VictorRavani/Belliz_IOT/Hardware/Placa V2 Fabricação/Rederização placa traseira.png

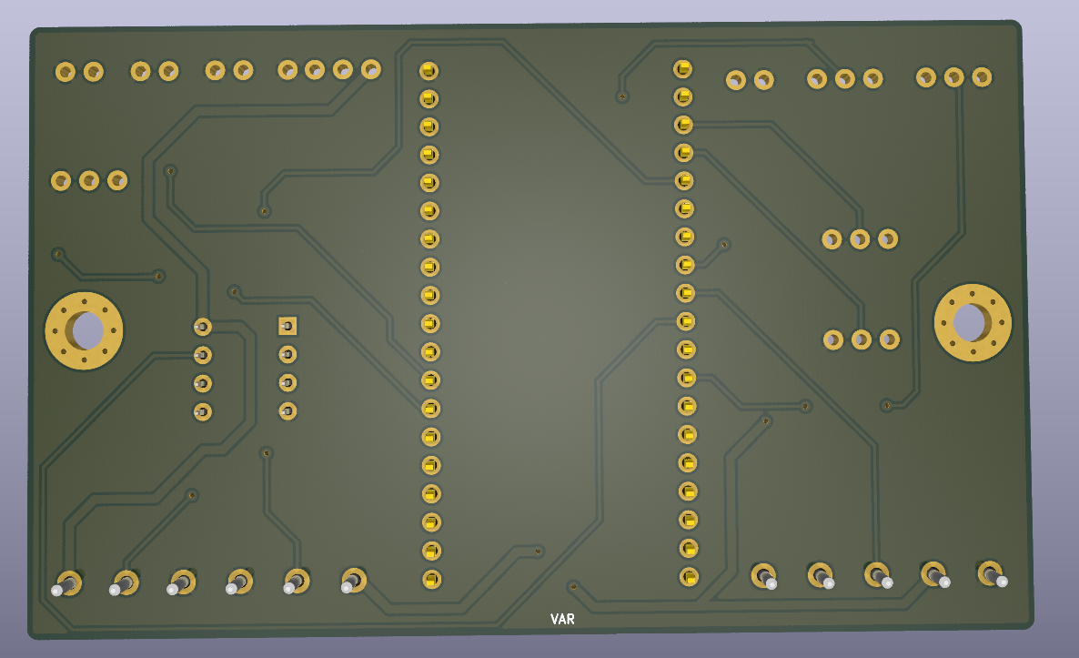
Hardware/Placa V2 Fabricação/Rederização placa traseira.png
