VictorRavani/Belliz_IOT/Documentos/Pinout ESP32 38pins.png

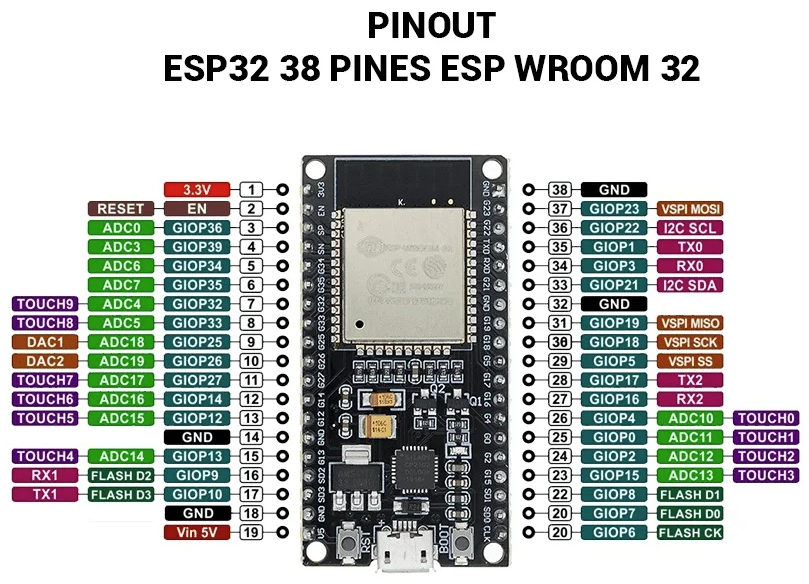
Documentos/Pinout ESP32 38pins.png
