VictorRavani/Belliz_IOT/Hardware/Identificação dos Cabos.xlsx

Nome | Quantidade
RELE 1 NA | 2
RELE 1 NA | 2
RELE 2 NA | 2
RELE 2 NA | 2
12V BZ | 2
GND BZ | 2
OUT FIRE | 2
12V DETECTOR | 2
GND DETECTOR | 2
