VictorRavani/Belliz_IOT/Documentos/Atualização OTA.docx

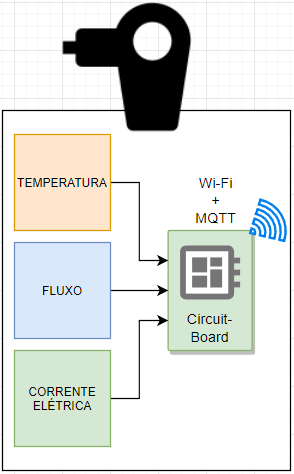
[picture p20: figure]

- Atualização OTA (Over-the-Air)
- Liga metade da planta por 15min e desliga 15min.
- NTP Server para atualização da hora.
- Enviar Json a cada 1 min
- Formato do Json:

{

"temp":158,

"flow":85,

"electric_current":8

}

- 16 Placas independentes para envio das informações p/

a plataforma da Azure.

- A placa 01 será um pouco diferente pois ela irá controlar

os ciclos de 15 min (conector KRE DNP)
