VictorRavani/Belliz_IOT/Documentos/Bancada de secadores.png

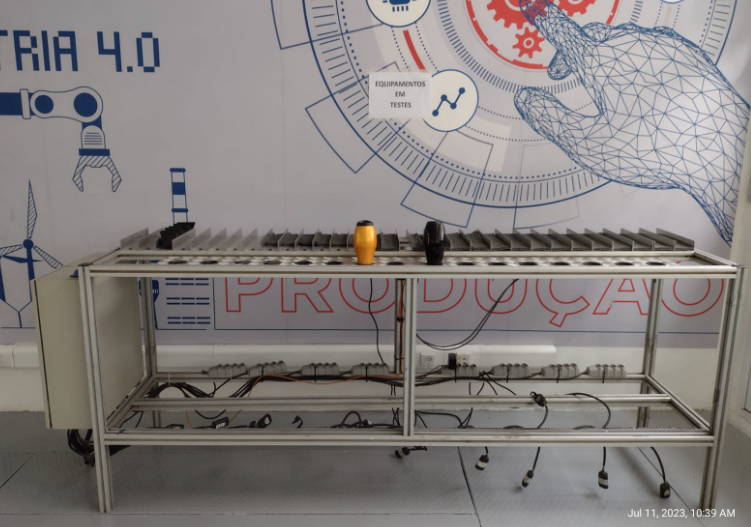
Documentos/Bancada de secadores.png
