VictorRavani/Belliz_IOT/Documentos/Captura de tela 2024-01-05 143502.png

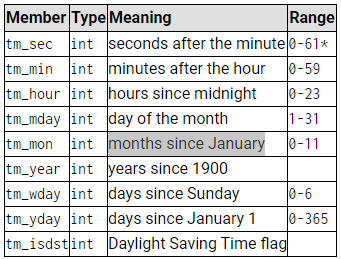
Documentos/Captura de tela 2024-01-05 143502.png
