VictorRavani/Belliz_IOT/Documentos/Esquema ligação ideia 1.png

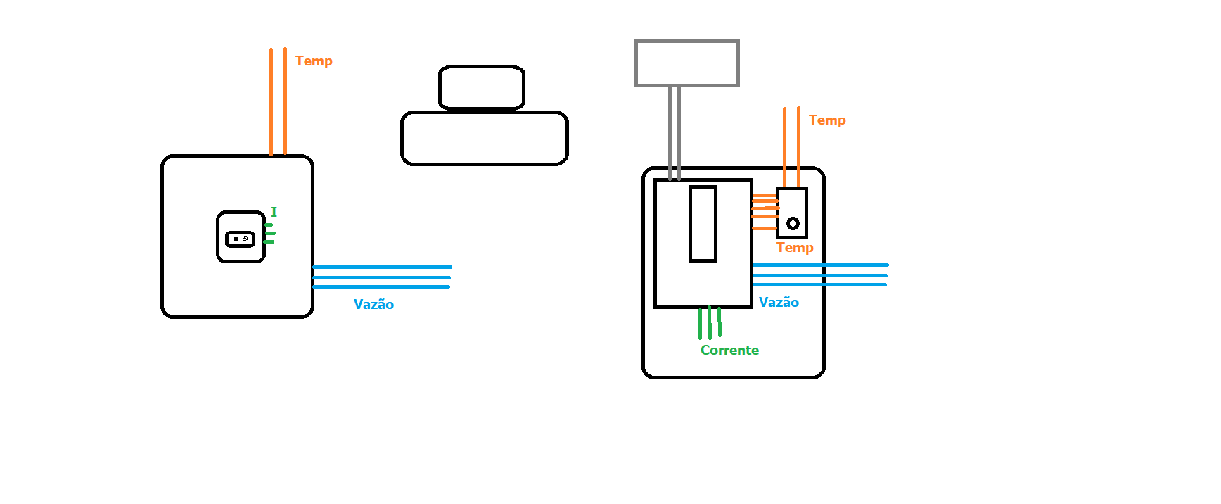
Documentos/Esquema ligação ideia 1.png
