VictorRavani/Belliz_IOT/Documentos/FireBaseConfig.png

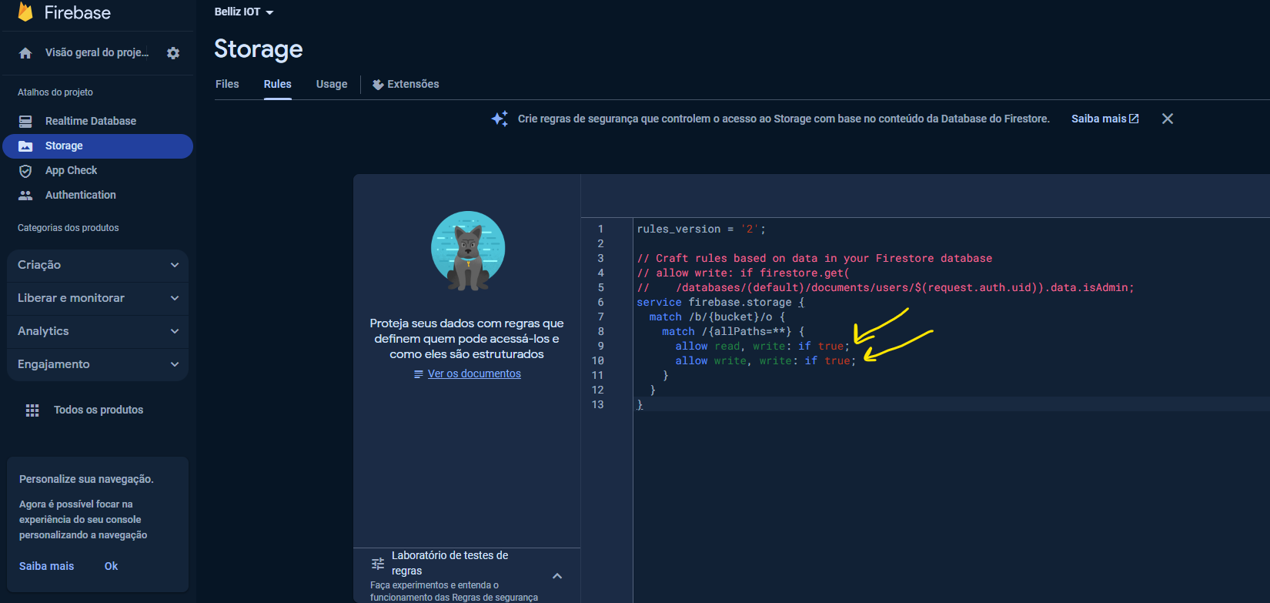
Documentos/FireBaseConfig.png
