VictorRavani/Belliz_IOT/Documentos/Placa 3D.png

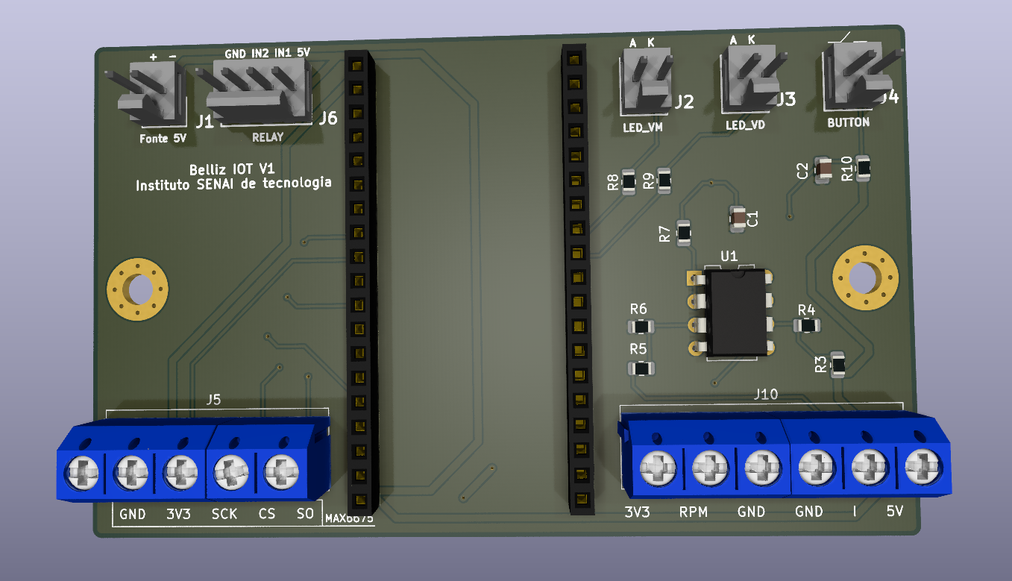
Documentos/Placa 3D.png
