VictorRavani/Belliz_IOT/Documentos/RPM.png

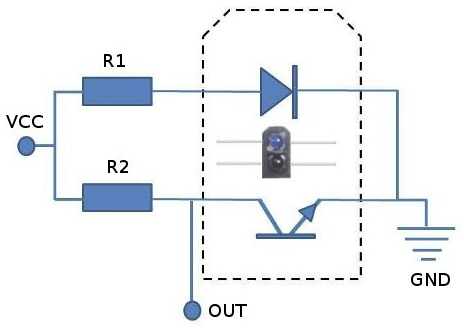
Documentos/RPM.png
