VictorRavani/Belliz_IOT/Gustavo/TAGO_IO.jpg

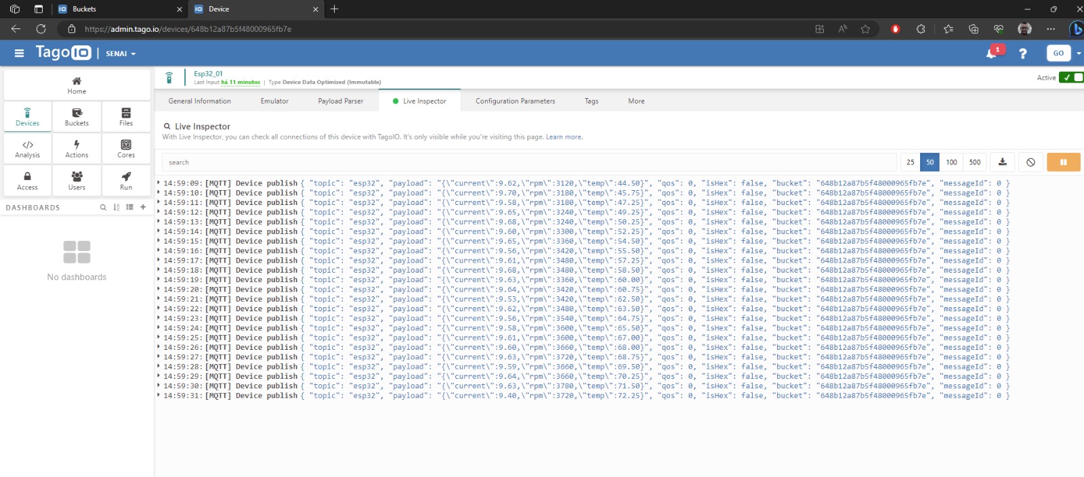
Gustavo/TAGO_IO.jpg
