VictorRavani/Belliz_IOT/Hardware/Circuito Elétrico/Circuito Relé.png

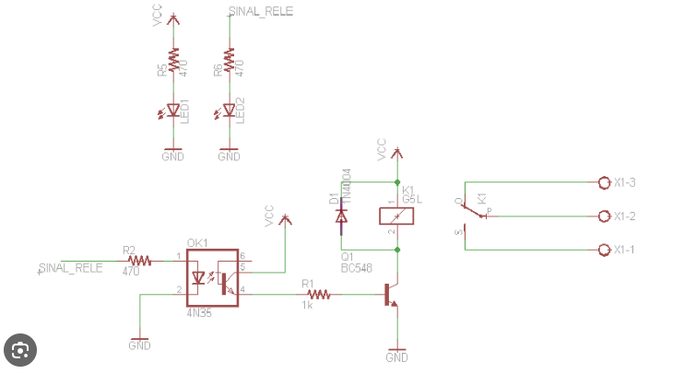
Hardware/Circuito Elétrico/Circuito Relé.png
