VictorRavani/Belliz_IOT/Hardware/Circuito Elétrico/Pin_Out_ESP32-38pins.png

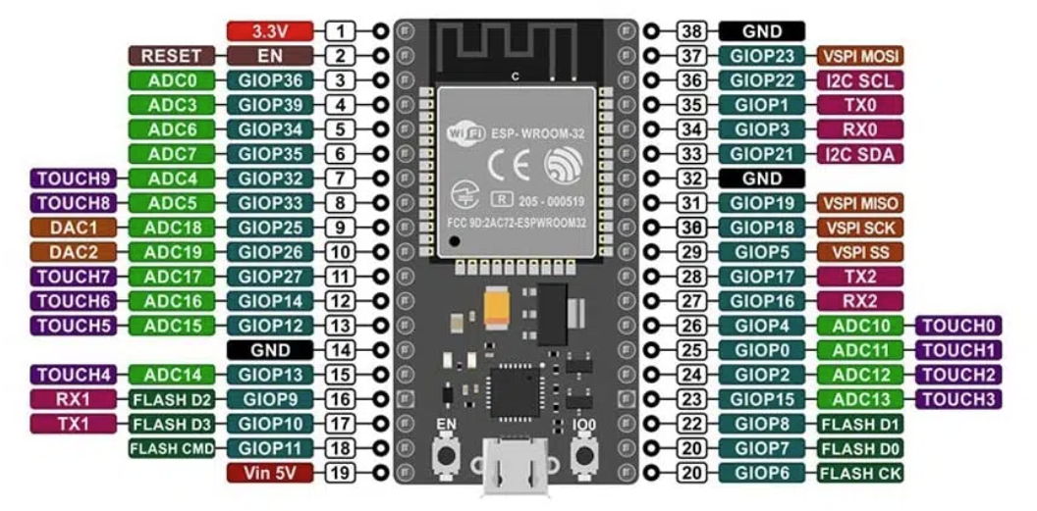
Hardware/Circuito Elétrico/Pin_Out_ESP32-38pins.png
