VictorRavani/Belliz_IOT/Hardware/PCB_Belliz_IOT.png

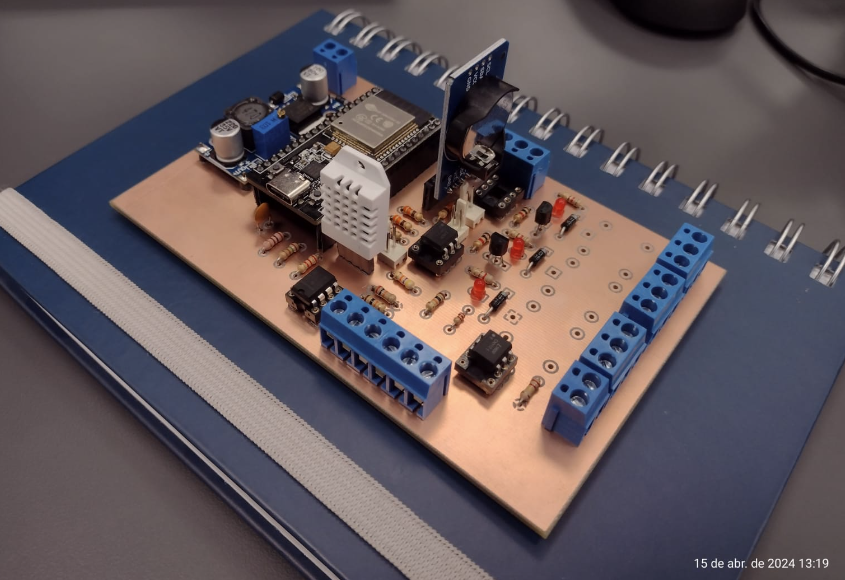
Hardware/PCB_Belliz_IOT.png
