VictorRavani/Belliz_IOT/Hardware/Circuito Elétrico/BoM - Bill of Materials - BELLIZ_IOT - (PCB v1.1).xlsx

Bill of Materials
Company Name: |  |  | Instituto SENAI de tecnologia em eletrônica e automação
 |  | Address | R. Jaguaré Mirim, 71 - Vila Leopoldina, São Paulo - SP, 05311-020 - Setor: IST - Eletrônica
 |  | Authorized persons | Victor Ravani; Gustavo Oliveira; Igor Messias; Fabio Rizzo
Project Name: |  |  | Belliz IOT – (PCB 1.1)
RESISTORS
ID | Qty. | Part Designator | Manufacturer Number | Description
1 | 1 | R1 | Resistor SMD 4K7 0805 0,125W (1/8W) 5% (https://www.mamuteeletronica.com.br/resistor-smd-4k7-0805-0125w-1-8w-5-713) | Resistor SMD 0805 4K7
2 | 8 | R2, R11, R12, R13, R14, R15, R16, R17 (All DNP) | Resistor SMD 0R 0805 | Resistor SMD 0805 0R
3 | 1 | R3 | Resistor SMD 750R 0805 | Resistor SMD 0805 750R
4 | 1 | R4 | Resistor SMD 2K2 0805 0,125W (1/8W) 5% (https://www.mamuteeletronica.com.br/resistor-smd-2k2-0805-0125w-1-8w-5-1029) | Resistor SMD 0805 2K2
5 | 2 | R5, R10 | Resistor SMD 10K 0805 0,125W (1/8W) 5% (https://www.mamuteeletronica.com.br/resistor-smd-10k-0805-0125w-1-8w-5-1028) | Resistor SMD 0805 10K
6 | 1 | R6 | Resistor SMD 20K 0805 | Resistor SMD 0805 20K
7 | 1 | R7 | Resistor SMD 100R 0805 | Resistor SMD 0805 100R
8 | 2 | R8, R9 | Resistor SMD 330R 0805 0,125W (1/8W) 5% (https://www.mamuteeletronica.com.br/resistor-smd-330r-0805-0125w-1-8w-5-1506) | Resistor SMD 0805 330R
CAPACITORS
ID | Qty. | Part Designator | Manufacturer Number | Description
1 | 2 | C1, C2 | Capacitor Cerâmico Smd 100nf 0805 50v X7r (https://www.mamuteeletronica.com.br/capacitor-ceramico-smd-100nf-0805-50v-x7r-k-10-4640) | Capacitor cerâmico SMD 0805 100nF
INTREGRATED CIRCUITS
ID | Qty. | Part Designator | Manufacturer Number | Description
1 | 1 | U1 | LM358 | Integrated Circuit
SYSTEM ON MODULE
ID | Qty. | Part Designator | Manufacturer Number | Description
1 | 1 | IC1 | ESP32 | Microcontroller
CONNECTORS
ID | Qty. | Part Designator | Manufacturer Number | Description
1 | 4 | J1, J2, J3, J4 | Conector KK 2 vias | Conector
2 | 1 | J6 | Conector KK 4 vias | Conector
3 | 5 | J7(DNP), J11, J12(DNP), J13(DNP), J14(DNP) | Conector KK 3 vias | Conector
4 | 1 | J10, | Conector KRE 6 vias | Conector
5 | 1 | J15 | Conector KRE 5 vias | Conector
6 | 2 | J8, J9 | Pin header female 19 vias | Conector
