VictorRavani/Belliz_IOT/Hardware/Placa V2 Fabricação/Lista de componentes.xlsx

#Or. | Components | Designator | Unitário | Quantidade | Final |  |  | Valor
1 | Alojamento metálico KK (fêmea) |  | 12 | 216 |  |  |  |  | 0
2 | Amplificador Operacional LM358 DIP |  | 1 | 18 |  |  | https://www.acheicomponentes.com.br/ci-lm358p-dip8-texas | 2 | 2
3 | Capacitor de cerâmica SMD 0805 100nF |  | 2 | 36 |  |  | https://www.acheicomponentes.com.br/capacitores/100-pecas-capacitor-ceramico-multicamadas-100nf-50v-smd-0805-10 | 15 | 15
4 | Conector KK 2 vias fêmea 180° |  | 4 | 72
5 | Conector KK 2 vias macho 180° |  | 4 | 72 |  | https://www.saravati.com.br/conector-kk-macho-2-54mm-02-vias-180o.html | https://www.acheicomponentes.com.br/conector/conector-kk-2-vias-macho-180-2-54mm-5045-02-ds1070-02mvv6 | 0.3 | 1.2
6 | Conector KK 3 vias fêmea 180° |  | 5 | 90
7 | Conector KK 3 vias macho 180° |  | 5 | 90 |  |  | https://www.acheicomponentes.com.br/conector/conector-kk-3-vias-macho-180-2-54mm-5045-03-ds1070-03mvv6 | 0.35 | 1.75
8 | Conector KK 4 vias fêmea 180° |  | 1 | 18
9 | Conector KK 4 vias macho 180° |  | 1 | 18 |  |  | https://www.acheicomponentes.com.br/conector/conector-kk-4-vias-macho-180-2-54mm-5045-04-ds1070-04mvv6 | 0.5 | 0.5
10 | Conector mini KRE 2 vias |  | 1 | 18 |  | https://www.saravati.com.br/borne-azul-kre2-kf-301-2-terminais-180-mini.html | https://www.acheicomponentes.com.br/borne-kre-2-vias-kf-301-2t-azul-mini | 1.55 | 1.55
11 | Conector mini KRE 3 vias |  | 3 | 54 |  | https://www.saravati.com.br/borne-azul-kre2-kf-301-3-terminais-180-mini.html | https://www.acheicomponentes.com.br/borne-kre-3-vias-kf-301-3t-azul-mini | 1.5 | 4.5
12 | Conector P4 rosca |  | 1 | 16 |  |  |  |  |  | 1504
13 | Resistor SMD 0805 0R |  | 4 | 72 |  |  | https://www.acheicomponentes.com.br/resistor/resistor-em-smd/0805/kit-100-pecas-resistor-0r-smd-0805-5 | 6 | 6
14 | Resistor SMD 0805 100R |  | 1 | 18 |  |  | https://www.acheicomponentes.com.br/resistor/resistor-em-smd/0805/100-pecas-resistor-100r-smd-0805-1 | 8 | 8
15 | Resistor SMD 0805 10K |  | 2 | 36 |  |  | https://www.acheicomponentes.com.br/resistor/resistor-em-smd/0805/100-pecas-resistor-10k-0805-smd-1 | 8 | 8
16 | Resistor SMD 0805 20K |  | 1 | 18 |  |  | https://www.acheicomponentes.com.br/resistor/resistor-em-smd/0805/100-pecas-resistor-20k-smd-0805-1 | 8 | 8
17 | Resistor SMD 0805 2K2 |  | 1 | 18 |  |  | https://www.acheicomponentes.com.br/resistor/resistor-em-smd/0805/100-pecas-resistor-2k2-smd-0805-1 | 8 | 8
18 | Resistor SMD 0805 330R |  | 2 | 36 |  |  | https://www.acheicomponentes.com.br/circuitos-integrados/dip-pth/100-pecas-resistor-330r-0-1w-smd-0805-5 | 8 | 8
19 | Resistor SMD 0805 4K7 |  | 1 | 18 |  |  | https://www.acheicomponentes.com.br/resistor/resistor-em-smd/0805/100-pecas-resistor-4k7-smd-0805-1 | 8 | 8
20 | Resistor SMD 0805 750R |  | 1 | 18 |  |  |  | 8 | 8
21 | Soquete Barra de Pinos 1x20 180 Graus Passo 2,54mm Fêmea | J8, J9 | 2 | 36 |  | https://www.saravati.com.br/soquete-barra-de-pinos-1x20-mci-180-graus-passo-2-54mm.html | https://www.acheicomponentes.com.br/barra-de-pinos/femea/20-vias-pinos/barra-de-pinos-femea-dupla-mci-1x20-180o-passo-2-54mm-ds1023-1-20s21 | 1.6 | 3.2
22 | Soquete Torneado 8 Pinos DIP |  | 1 | 18 |  |  | https://www.acheicomponentes.com.br/soquete/torneado/soquete-torneado-dip-pth-8-pinos-ou-pernas | 2.4 | 2.4
 | Kit 5 peças - Rele 5V 15A 5 pinos - Metaltex (AX1RC) |  |  | 3
