VictorRavani/Belliz_IOT/Documentos/Compras 3 Belliz_IOT.xlsx

Descrição | Qty | Valor Uni. | Total
Sensor de Temperatura e Umidade Digital DHT22 (https://www.saravati.com.br/sensor-de-temperatura-e-umidade-digital-dht22.html) | 2 | R$39.90 | R$79.80
Adaptador Plugue P4 Macho x Borne (https://www.saravati.com.br/adaptador-plugue-p4-macho-x-borne.html) | 5 | R$3.00 | R$15.00
Fonte Bivolt 100-240V 12V 1A Plug P4 (https://www.saravati.com.br/fonte-bivolt-100-240v-12v-1a-plug-p4.html) | 16 | R$17.90 | R$286.40
Módulo Regulador de Tensão LM2596 DC/DC Step Down (https://www.saravati.com.br/modulo-regulador-de-tensao-lm2596-dc-dc-step-down.html) | 16 | R$11.90 | R$190.40
Total |  |  | R$571.60
