VictorRavani/Belliz_IOT/Documentos/gráficos.xlsx

Sheet: Planilha1
Entregue | Conector Tomada 3 pinos 10A | 16 | R$14.00 | R$224.00 | PCB's | Usar ACS fusíveis, medir temperatura
Entregue | Plug Tomada 3 pinoa 10A | 16 | R$5.00 | R$80.00 | Componentes Eletrônicos
Entregue | Placa ESP32 WiFi / Bluetooth ESP32S CP2102 38 Pinos | 16 | R$64.43 | R$1030.88
 |  |  |  | R$0.00
Entregue | Sensor de Corrente ACS712 20A | 16 | R$15.21 | R$243.36
Entregue | Módulo de Temperatura MAX6675 + Sensor Termopar tipo K | 16 | R$49.41 | R$790.56
Entregue | TCRT5000 | 16 | R$1.99 | R$31.84
Entregue | Microventilador 110-220Vac 50/60Hz 80x80mm | 16 | R$54.60 | R$873.60
Entregue | Tubo de PVC 12 metros | 16 |  | R$0.00
 | Impressão 3D case temperatura | 16 |  | R$0.00
 | Cabo Manga blindado 5 vias |  |  | R$0.00
 | Fabricação e montagem das placas completa |  |  | R$0.00
 | Conversor ADS1115 |  |  | R$0.00
 | Parafusos caixa patola externo 4 uni |  |  | R$0.00
 | Parafusos Placa 2 uni |  |  | R$0.00
Entregue | Caixa patola Placa |  |  | R$0.00
Entregue | Fonte para ESP32 5V 2.2A Micro USB | 16 | 18.41 | R$294.56
 | Parafusos caixa patola e tomada sobrepor 4 unidades |  |  | R$0.00
 | Parafuso case 3D sensor de temperatura unidades |  |  | R$0.00
 | Parafuso e procas ventilador e tudo 4 uni pequeno 4 uni grande |  |  | R$0.00
 | Parafuso tubo e bancada 6 uni e 6 porcas |  |  | R$0.00
 |  |  |  | R$0.00
 |  |  |  | R$0.00
 |  |  |  |  |  | Temperatura de trabalho TCRT5000: -25 °C ~ +85 °C
 | https://www.usinainfo.com.br/sensor-de-fluxo-arduino/sensor-de-fluxo-de-agua-yf-s403-g34-1-60-lmin-3523.html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
 | https://www.baudaeletronica.com.br/sensor-de-fluxo-de-agua-3-4-yf-s403.html
 | https://www.saravati.com.br/sensor-de-corrente-nao-invasivo-sct-013-20a-1v.html

Sheet: Custo unitário
 |  |  |  |  | Custo Máximo: | R$1250.00
 | Placa ESP32 | 1 | R$58.41 | link (https://www.saravati.com.br/produto/placa-esp32-wifi-bluetooth-esp32-cp2102-30-pinos-usb-c.html) | Custo Atual: | R$805.29
ok | Conjunto Tomada de Sobrepor 2P+T 20A 250V Box Branco | 1 | R$7.50 | link (https://www.obramax.com.br/conjunto-tomada-de-sobrepor-2pt-20a-250v-box-branco-89151552.html?region_id=138913)
ok | PLUG DE SOBREPOR 2P+T 20A MACHO PRETO FAME | 1 | R$7.93 | link (https://www.eletrorastro.com.br/produto/plug-de-sobrepor-2p-t-20a-macho-preto-fame-81553)
 | Caixa Patola PB-115 para Montagem 50 x 112 x 160 mm | 1 | R$33.73 | link (https://www.usinainfo.com.br/caixas-patola/caixa-patola-pb-115-para-montagem-50-x-112-x-160-mm-8282.html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)
 | Tubo de PVC | 1 | R$50.00 |  |  |  | Processo de compras 1 - Eletrônica
 | PCB | 1 | R$100.00 |  |  |  | Descrição | Quantidade | Link referência
ok | Sensor de Temperatura MAX6675 com Termopar Tipo K | 1 | R$33.70 | link (https://www.wjcomponentes.com.br/sensores/max-6675-com-termopar-tipo-k?parceiro=6298) |  |  | Caixa Plástica PB-115 - Patola - Caixa 24 | 17 | link (https://www.multcomercial.com.br/caixa-plastica-pb-115-patola-caixa-24.html) | Eletrônica
ok | Sensor de Corrente ACS712 20A | 1 | R$15.21 | link (https://www.saravati.com.br/sensor-de-corrente-acs712-20a) |  |  | Fonte Bivolt 100-240V 5V 1A Plug P4 | 17 | link (https://www.saravati.com.br/fonte-bivolt-100-240v-5v-1a-plug-p4) | Eletrônica
 | Sensor de Vazão | 1 | R$294.50 | link (https://www.marinostore.com/sensores/sensor-de-fluxo-de-agua-2-polegada-fy-dn50) |  |  | Placa ESP32 WiFi / Bluetooth ESP32 CP2102 38 Pinos USB-C | 17 | link (https://www.saravati.com.br/produto/placa-esp32-wifi-bluetooth-esp32-cp2102-30-pinos-usb-c.html) | Eletrônica
 | Componentes da placa | 1 | R$150.00 |  |  |  | Sensor de Corrente ACS712 20A | 17 | link (https://www.saravati.com.br/sensor-de-corrente-acs712-20a) | Eletrônica
Delanese | Parafusos e peças mecânicas | 1 | R$40.00 |  |  |  | Sensor de Temperatura MAX6675 com Termopar Tipo K | 17 | link (https://www.saravati.com.br/modulo-sensor-de-temperatura-max6675-termopar-tipo-k) | Eletrônica
 | Fonte Bivolt 100-240V 5V 1A Plug P4 | 1 | R$14.31 | link (https://www.saravati.com.br/fonte-bivolt-100-240v-5v-1a-plug-p4) |  |  | Sensor Optico TCR5000 | 36 | link (https://www.saravati.com.br/sensor-optico-reflexivo-infrared-fototransistor-tcrt5000) | Eletrônica
 |  |  |  |  |  |  | Microventilador Cooler RT-080 12VDC 5.000RPM 4.20 Watts (80x80x25mm) Rolamento - 14.104-HH - Nework | 17 | link (https://www.multcomercial.com.br/microventilador-cooler-rt-080-12vdc-5-000rpm-4-20-watts-80x80x25mm-rolamento-14-104-hh-nework.html) | Eletrônica
 |  |  |  |  |  |  | Tubo de PVC (Medida da plataforma) |  | link | Mecânica | Ver na PJ
 | https://www.usinainfo.com.br/coolers-para-pc/cooler-pc-80mm-fan-12v-3042.html |  |  |  |  |  | Parafusos e porcas Volvo, contoneiras Impressas. |  | link | Mecânica | SENAI
 |  |  |  |  |  |  | Conjunto Tomada de Sobrepor 2P+T 20A 250V Box Branco | 17 | link | Elétrica | PJ
 |  |  |  |  |  |  | PLUG DE SOBREPOR 2P+T 20A MACHO PRETO | 17 | link | Elétrica | PJ
ok | Fonte 5v 1A conector P4 | 18 |  |  |  |  |  |  | link
ok | Placa ESP32 38 pinos conector tipo C | 18
ok | Sensor de Corrente ACS712 20A | 18 |  |  |  |  | Processo de compras 2 - Elétrica
ok | Conjunto Tomada de Sobrepor 2P+T 20A 250V Box Branco | 1 | ver fornecedor |  |  |  | Descrição | Quantidade | Link referência
ok | PLUG DE SOBREPOR 2P+T 20A MACHO PRETO FAME | 1 | ver fornecedor |  |  |  | Conjunto Tomada de Sobrepor 2P+T 20A 250V Box Branco | 17 | link | Elétrica | PJ
ok | Sensor de Temperatura MAX6675 com Termopar Tipo K | 18 |  |  |  |  | PLUG DE SOBREPOR 2P+T 20A MACHO PRETO | 17 | link | Elétrica | PJ
ok | Microventilador 80X80x25 RPM > 2500 | 2
ok | Sensor Optico TCR5000 | 36
 | Tubo de PVC (Medida da plataforma) | 1 | Caixinha
 | Parafusos e peças mecânicas | 1 | Caixinha

Sheet: Planilha2
Contagem de pulsos
Tipo de sensor | Suporte 3D | Circuito Auxiliar | O que será o gatilho | Dificuldades | Exatidão | Custo | Precisão
Reed Switch | Sim | Não | Imã neodímio | Prender o Imã |  | Baixo
Sensor Hall | Sim | Sim (resistor e cap) | Imã neodímio | Prender o Imã |  | Baixo
Sensor óptico (direto) | Sim | Sim (AmpOp) | Hélice | Alinhamento do sensor | Boa | Baixo | Boa
Sensor óptico (refletindo) | Sim | Sim (AmpOp) | Fita branca | Precisão e exatidão | Ruim | Baixo | Ruim
 |  | *A precisão é quantificada como o desvio padrão de uma série de medidas. *A exatidão de uma medida é a distância estimada entre a medida e um valor “verdadeiro”
Contagem de pulsos
 |  | Dificuldade do Imã: o cooler possui metal e esse metal interage com o metal do motor, isso diminui a rotação do cooler.

Sheet: Planilha3
Curva do sensor de vazão de água
L/H | Hz
120 | 16
240 | 32.5
360 | 49.3
480 | 65.5
600 | 82
720 | 90.2
451.753 | 60 | 7.529216667

Sheet: BOM Total
Descrição | Quantidade | Link referência
Caixa Plástica PB-115 - Patola - Caixa 24 | 17 | link (https://www.multcomercial.com.br/caixa-plastica-pb-115-patola-caixa-24.html)
Fonte Bivolt 100-240V 5V 1A Plug P4 | 17 | link (https://www.saravati.com.br/fonte-bivolt-100-240v-5v-1a-plug-p4)
Placa ESP32 WiFi / Bluetooth ESP32 CP2102 38 Pinos USB-C | 17 | link (https://www.saravati.com.br/produto/placa-esp32-wifi-bluetooth-esp32-cp2102-30-pinos-usb-c.html)
Sensor de Corrente ACS712 20A | 17 | link (https://www.saravati.com.br/sensor-de-corrente-acs712-20a)
Sensor de Temperatura MAX6675 com Termopar Tipo K | 17 | link (https://www.saravati.com.br/modulo-sensor-de-temperatura-max6675-termopar-tipo-k)
Sensor Optico TCR5000 | 36 | link (https://www.saravati.com.br/sensor-optico-reflexivo-infrared-fototransistor-tcrt5000)
Microventilador Cooler RT-080 12VDC 5.000RPM 4.20 Watts (80x80x25mm) Rolamento - 14.104-HH - Nework | 17 | link (https://www.multcomercial.com.br/microventilador-cooler-rt-080-12vdc-5-000rpm-4-20-watts-80x80x25mm-rolamento-14-104-hh-nework.html)
Conjunto Tomada de Sobrepor 2P+T 20A 250V Box Branco | 17 | link
PLUG DE SOBREPOR 2P+T 20A MACHO PRETO | 17 | link
Tubo de PVC 76mm diametro 500mm comprimento | 17
Parafusos | 100
Porcas | 100

Sheet: ACS712
 | A | Serial | V
 | 4.4
 | 2.4
 | 1.5
 | 0.3 | 3080
 | 0 | 3030 | 2.52 |  |  |  | 80mV/div
2321 | 3531 | 2529 | 3303 | 3024
2359 | 3625 | 2511 | 3362 | 3033
2423 | 3714 | 2528 | 3408 | 3024
2474 | 3824 | 2514 | 3411 | 3050
2518 | 3893 | 2528 | 3478 | 3030
2590 | 4018 | 2529 | 3492 | 3042
2667 | 4022 | 2513 | 3513 | 3036
2709 | 4095 | 2572 | 3543 | 3044
2796 | 4095 | 2534 | 3557 | 3027
2659 | 4095 | 2516 | 3571 | 3031
2592 | 4095 | 2518 | 3594 | 3044
2537 | 4095 | 2512 | 3593 | 3024
2507 | 4095 | 2528 | 3565 | 3027
2448 | 4095 | 2502 | 3591 | 3039
2404 | 2401 | 2540 | 3605 | 3035
2384 | 2480 | 2523 | 3601 | 3037
2340 | 2541 | 2522 | 3583 | 3046
2326 | 2599 | 2511 | 3605 | 3026
2315 | 2667 | 2512 | 3603 | 3031
2303 | 2726 | 2509 | 3536 | 3046
2290 | 2769 | 2507 | 3522 | 3024
2286 | 2855 | 2508 | 3455 | 3052
2279 | 2896 | 2507 | 3434 | 3041
2266 | 2973 | 2531 | 3383 | 3035
2266 | 3037 | 2516 | 3325 | 3024 |  |  |  | 4,4A
2256 | 3124 | 2518 | 3278 | 3043 |  |  |  | Maior V | multiplicação
2251 | 3184 | 2505 | 3278 | 3027 |  |  |  | 4095 | 3,3V
2259 | 3264 | 2528 | 3216 | 3029
2304 | 3362 | 2526 | 3185 | 3025
2326 | 3471 | 2503 | 3137 | 3026
2338 | 3568 | 2511 | 3090 | 3018
2389 | 3663 | 2512 | 3043 | 3029
2439 | 3757 | 2503 | 3402 | 3020
2498 | 3815 | 2506 | 3470 | 3024
2559 | 3941 | 2511 | 3478 | 3025 |  |  |  | ter
2638 | 4035 | 2513 | 3501 | 3033
2691 | 4071 | 2526 | 3515 | 3041
2743 | 4095 | 2491 | 3565 | 3037
2806 | 4095 | 2499 | 3581 | 3035
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
 | 4095
 | 4095
 | 4095
 | 4095
 | 4095
 | 2691
 | 2768
 | 2821
 | 2880
 | 2941
 | 3002
 | 3070
 | 3159
 | 3218
 | 3303
 | 3435
 | 3568
 | 3615
 | 3705
 | 3793
 | 3901
 | 4046
 | 4021
 | 4095
 | 4095
 | 4095
 | 4095
 | 4095
 | 4095
 | 4095
 | 4095
 | 4095
 | 4095
 | 4095
 | 4095
 | 4095
 | 4095

Sheet: Planilha4
0 | 1.65 | 3.3
0 | 2047 | 4095 |  |  |  | 1993 |  |  |  |  |  | -4 | -4 | 16
 | Tesão [V] | Valor ADC
0 | 0 | -0.1667 |  | y = 1240,9x - 0,1667 |  |  |  |  | 1968
620 | 0.5 | 620.2833
1241 | 1 | 1240.7333 |  | 1.65 | 2047.3183
1861 | 1.5 | 1861.1833 |  | 1.12 | 1389.6413 | 3,5A | 2413
2482 | 2 | 2481.6333 |  | 3.3 | 4094.8033
3102 | 2.5 | 3102.0833
3723 | 3 | 3722.5333
4095 | 3.3 | 4094.8033
 | Amperimetro | Osc Max | RMS | Mean | Min |  | Terminal | RMS
 | 0A | 1.76 | 1.65 | 1.65 | 1.56 |  | 1990 | 1959 | 1964
 | 0.2A | 1.8 | 1.66 | 1.66 | 1.56 |  | 2011 | 1977 | 1982
 | 1,3A | 1.96 | 1.73 | 1.72 | 1.56 |  | 2087 | 2054 | 2060
 | 2,4A | 2.16 | 1.79 | 1.78 | 1.56 |  | 2165 | 2139 | 2140
 | 4,4A | 2.12 | 2.12 | 1.64 | 1.16 |  | 1991 | 1991
 |  | 2 | 5 | 8 | 9 | 4
 |  | 4 | 25 | 64 | 81 | 16 | 0 | 0 | 190 | 38 | 6.164414003

Sheet: Planilha6
ACS712 20A |  | RMS
A | V Pk | Vpk * 0,7 | RMS*1,41 |  | 20 | Tensão Pk | 3.3 | RMS Max | 2.33 | 2895.386587
0 | 1.68 | 1.187928 | 1.67497848 | 100mV/A |  | Tensão Pk | 3.2 |  | 2.26 | 2807.642548
1 | 1.8 | 1.27278 | 1.7946198 |  |  | Tensão Pk | 3.1 |  | 2.19 | 2719.898509
2 | 1.88 | 1.329348 | 1.87438068 |  |  | Tensão Pk | 3 |  | 2.12 | 2632.15447
3 | 2 | 1.4142 | 1.994022 |  |  | Tensão Pk | 2.9 |  | 2.05 | 2544.410431
4 | 2.04 | 1.442484 | 2.03390244 |  |  | Tensão Pk | 2.8 |  | 1.98 | 2456.666392
5 | 2.16 | 1.527336 | 2.15354376 |  |  | Tensão Pk | 2.7 |  | 1.91 | 2368.922353
6 | 2.2508 |  |  |  |  | Tensão Pk | 2.6 |  | 1.84 | 2281.178314
7 | 2.3434 |  |  |  | 10 | Tensão Pk | 2.5 |  | 1.77 | 2193.434275
8 | 2.436 |  |  |  |  | Tensão Pk | 2.4 |  | 1.70 | 2105.690236
9 | 2.5286 |  |  |  |  | Tensão Pk | 2.3 |  | 1.63 | 2017.946197
10 | 2.6212 |  |  |  |  | Tensão Pk | 2.2 |  | 1.56 | 1930.202158
11 | 2.7138 |  |  |  | 5A | Tensão Pk | 2.1 |  | 1.48 | 1842.458119
12 | 2.8064 |  |  |  | 4A | Tensão Pk | 2 |  | 1.41 | 1754.71408
13 | 2.899 |  |  |  | 3A | Tensão Pk | 1.9 |  | 1.34 | 1666.970041
14 | 2.9916 |  |  |  | 2A | Tensão Pk | 1.8 |  | 1.27 | 1579.226002
15 | 3.0842 |  |  |  | 1A | Tensão Pk | 1.7 |  | 1.20 | 1491.481963
16 | 3.1768 |  |  |  | 0 | Tensão Pk | 1.65 | RMS Min | 1.17 | 1447.609944
17 | 3.2694 |  |  |  |  | Tensão Pk | 1.5 |  | 1.06 | 1315.993885
18 | 3.362 |  |  |  |  | Tensão Pk | 1.4 |  | 0.99 | 1228.249846
19 | 3.4546 |  |  |  |  | Tensão Pk | 1.3 |  | 0.92 | 1140.505807
20 | 3.5472 |  |  |  |  | Tensão Pk | 1.2 |  | 0.85 | 1052.761768
 |  |  |  |  |  | Tensão Pk | 1.1 |  | 0.78 | 965.017729
 |  |  |  |  |  | Tensão Pk | 1 |  | 0.71 | 877.27369
 |  |  |  |  |  | Tensão Pk | 0.9 |  | 0.64 | 789.529651
 |  |  |  |  |  | Tensão Pk | 0.8 |  | 0.57 | 701.785612
 |  |  |  |  |  | Tensão Pk | 0.7 |  | 0.49 | 614.041573
 |  |  |  |  |  | Tensão Pk | 0.6 |  | 0.42 | 526.297534
 |  |  |  |  |  | Tensão Pk | 0.5 |  | 0.35 | 438.553495
 |  |  |  |  |  | Tensão Pk | 0.4 |  | 0.28 | 350.809456
 |  |  |  |  |  | Tensão Pk | 0.3 |  | 0.21 | 263.065417
 |  |  |  |  |  | Tensão Pk | 0.2 |  | 0.14 | 175.321378
 |  |  |  |  |  | Tensão Pk | 0.1 |  | 0.07 | 87.577339

Sheet: Planilha5
1937
2029
2074
2081 | pico
2031
1982
1911
1872
1867 | vale
1904
1963
2032
2071
2082 | pico
2041
1975
1913
1871
1868
1916
1955
2033
2075
2093
2032 |  | 2035
1979 |  | 2067
1919 |  | 2079
1872 |  | 2041
1830 |  | 1994
1909 |  | 1908
1968 |  | 1882
2037 |  | 1867
2076 |  | 1895
2077 |  | 1949
2031 |  | 2014
1970 |  | 2064
1914 |  | 2071
1874 |  | 2062
1842 |  | 1988
1909 |  | 1928
1967 |  | 1878
2039 |  | 1861
2074 |  | 1893
2080 |  | 1947
2032 |  | 2013
1971 |  | 2064
1914 |  | 2075
1885 |  | 2054
1863 |  | 1990
1918 |  | 1932
1971 |  | 1882
2037 |  | 1821
2089 |  | 1897
2070 |  | 1948
2045 |  | 2015
1975 |  | 2075
1904 |  | 2079
1881 |  | 2045
1875 |  | 1990
1911 |  | 1936
1968 |  | 1873
2033 |  | 1869
2047 |  | 1901
2080 |  | 1945
2038 |  | 2019
1967 |  | 2065
1915 |  | 2084
1873 |  | 2051
1874 |  | 1988
1913 |  | 1929
1975 |  | 1879
2037 |  | 1869
2075 |  | 1891
2080 |  | 1926
2057 |  | 2009
1974 |  | 2064
1915 |  | 2079
1872 |  | 2046
1872 |  | 1987
1915 |  | 1968
1971 |  | 1882
1963 |  | 1864
2077 |  | 1899
2074 |  | 1949
2035 |  | 2016
1978 |  | 2066
1906 |  | 2082
1857 |  | 2052
1895 |  | 1995
1903 |  | 1931
1964 |  | 1881
2032 |  | 1857
2069 |  | 1890
2079 |  | 1948
2031 |  | 2014
1971 |  | 2064
1905 |  | 2082
1878 |  | 2061
1872 |  | 2017
1922 |  | 1931
1971 |  | 1878
2032 |  | 1865
2081 |  | 1895
2079 |  | 1954
2045 |  | 2010
1976 |  | 2069
1904 |  | 2071
1857 |  | 2057
1867 |  | 1986
1901 |  | 1934
1980 |  | 1873
2037 |  | 1881
2110 |  | 1899
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
 |  | 1875 |  | 1547
 |  | 1853 |  | 1500
 |  | 1891 |  | 1452
 |  | 1948 |  | 1437
 |  | 2025 |  | 1411
 |  | 2069 |  | 1418
 |  | 2071 |  | 1417
 |  | 2057 |  | 1415
 |  | 1990 |  | 1456
 |  | 1920 |  | 1508
 |  | 1883 |  | 1586
 |  | 1872 |  | 1669
 |  | 1907 |  | 1759
 |  | 1951 |  | 1844
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
