VictorRavani/Belliz_IOT/Documentos/Parafusos Belliz.xlsx

Sheet: Parafusos
Compra de parafusos Dall'anese
Ordem | Descrição | Tamanho | Quantidade | Localização | Link | Valor Uni | Valor total
1 | Parafuso Allen com Cabeça Din 912 MM Oxidado | M4X12MM | 200 | Belliz - Suporte L | link (https://www.dallanese.com.br/8175/pf-allen-c-cabea-mm-ma-oxi) | R$0.33 | R$66.00
2 | Parafuso Allen com Cabeça Din 912 MM Oxidado | M4X30MM | 100 | Belliz - Microventilador | link (https://www.dallanese.com.br/8175/pf-allen-c-cabea-mm-ma-oxi) | R$0.30 | R$30.00 | R$276.00
3 | Parafuso Plastic Panela Phillips Zincado | 3X6 | 200 | Belliz - Caixa patola e placa | link (https://www.dallanese.com.br/9524/pf-plastic-panela-phillips-znb) | R$0.06 | R$12.00
4 | Parafuso Chipboard Chata Phillips Bicromatizado | 4,5X16 | 100 | Belliz - Tomada sobrepor | link (https://www.dallanese.com.br/812/parafuso-chipboard-chata-phillips-bicromatizado) | R$0.07 | R$7.00
5 | Porca Convencional Din 934 Inox 304 MM | M4 CH7 | 300 | Belliz - Porcas | link (https://www.dallanese.com.br/8018/porca-convencional-ma-inox-304) | R$0.17 | R$51.00
6 | Parafuso Allen Din 7991 Chata Aço MM Oxidado | M5x16 | 100 | Reposição Automação |  | R$0.28 | R$28.00
7 | Parafuso Allen com Cabeça Din 912 MM Oxidado | M6x20 | 100 | Reposição Automação |  | R$0.43 | R$43.00
8 | Parafuso Allen com Cabeça Din 912 MM Oxidado | M5x25 | 100 | Reposição Automação |  | R$0.39 | R$39.00
9 | Parafuso Máquina Panela Phillips Din 7985 Bicromatizado MM | M3x20 | 100 | Reposição Automação |  | R$0.07 | R$7.00
10 | Parafuso Allen sem Cabeça Din 916 MM Oxidado | M3X5 | 100 | Reposição Automação |  | R$0.16 | R$16.00
11 | Parafuso Allen sem Cabeça Din 916 MM Oxidado | M4X6 | 100 | Reposição Automação |  | R$0.16 | R$16.00
12 | Parafuso Allen sem Cabeça Din 916 MM Oxidado | M5X8 | 100 | Reposição Automação |  | R$0.19 | R$19.00
13 | Porca Convencional Din 934 Aço 5.8 Zincado MM | M4 | 100 | Reposição Automação |  | R$0.06 | R$6.00
14 | Porca Convencional Din 934 Aço 5.8 Zincado MM | M5 | 100 | Reposição Automação |  | R$0.10 | R$10.00
15 | Parafuso Atarrachante Panela Phillips Din 7981 Zincado | 3,9X13 | 100 | Reposição Automação |  | R$0.11 | R$11.00
16 | Parafuso Allen com Cabeça Din 912 Inox 304 MM | M3X20 | 100 | Reposição Automação |  | R$0.33 | R$33.00
 |  |  |  |  |  | Total: | R$394.00

Sheet: Itens diversos
Compra de parafusos Dall'anese
Ordem | Descrição | Quantidade
1 | Módulo Relé 2 vias (https://www.saravati.com.br/modulo-rele-5v-10a-2-canais.html) | 1
2 | Buzzer BZ20-9L-R Metaltex (https://www.metaltex.com.br/assets/produtos/pdf/bz.pdf) | 1 | 28
 | Módulo Relé 2 vias
 | Módulo Relé 5V 10A 2 Canais (https://www.saravati.com.br/modulo-rele-5v-10a-2-canais.html) |  | 14.31
