VictorRavani/Belliz_IOT/Documentos/Custos do Projeto.xlsx

Descrição | Valor |  | 1500 | placas
Panda Max | -R$355.35 |  | 1800 | componentes
Multi Comercial | -R$1975.40 |  | 800 | Perfil
Saravati | -R$2778.04 |  | 350 | Telhado
Mixx Metais (Tubos) | -R$471.70 |  |  | Buzzer
Detector de fumaça | -R$188.00 |  |  | Lamparina
Perfil de alumínio |  |  | 4450
Policarbonato
Parafusos | -R$167.00
Placas
Componentes Placa
Valor disponível | R$20000.00 | 100%
Redução Rizzo | -R$9000.00 | -45%
Total gasto | -R$5935.49 | -29.67745%
Resultado | R$5064.51
