VictorRavani/Belliz_IOT/Hardware/Placa V2 Fabricação/Dimensão altura.png

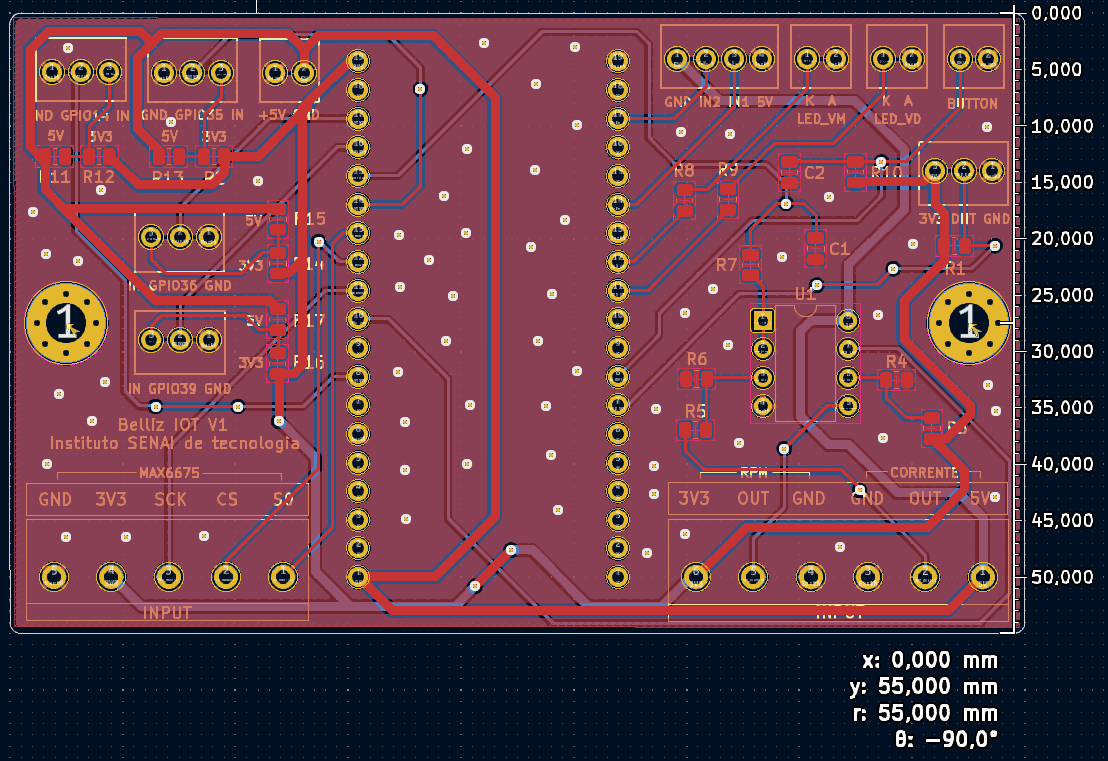
Hardware/Placa V2 Fabricação/Dimensão altura.png
