VictorRavani/Belliz_IOT/Hardware/Placa V2 Fabricação/Dimensão largura.png

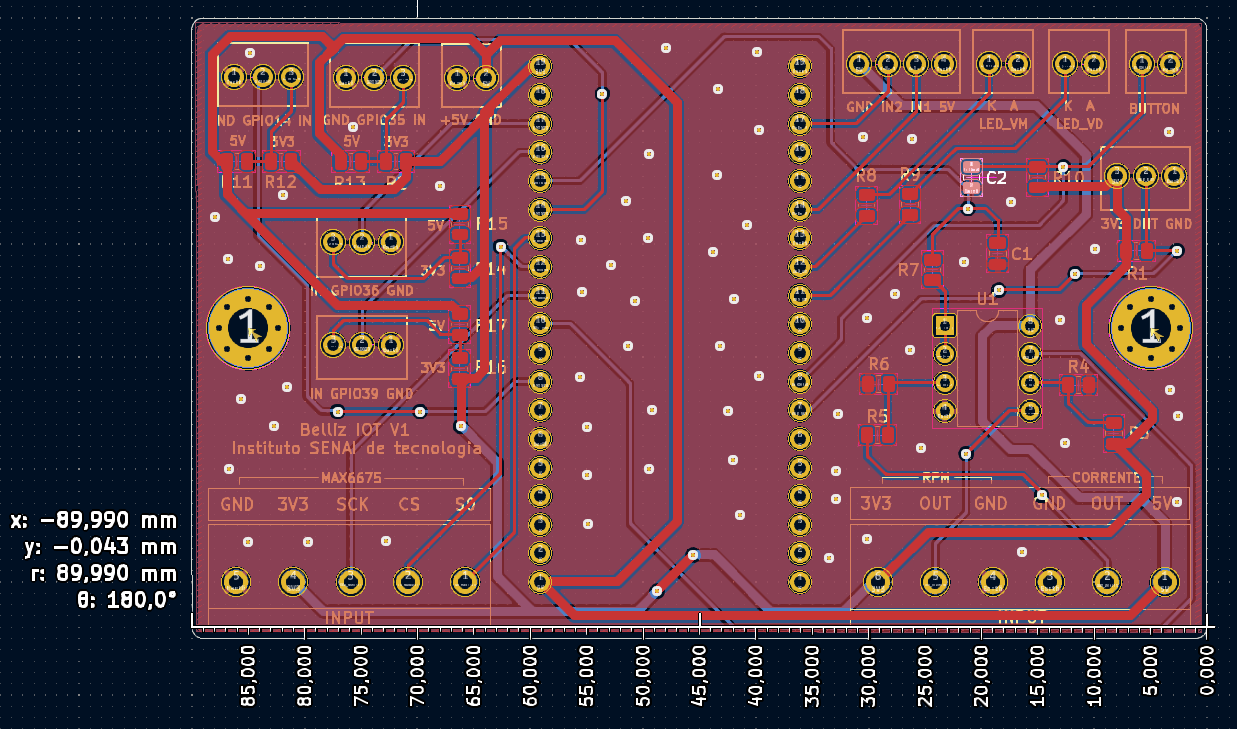
Hardware/Placa V2 Fabricação/Dimensão largura.png
