VictorRavani/Belliz_IOT/Hardware/Placa V2 Fabricação/Rederização placa frontal.png

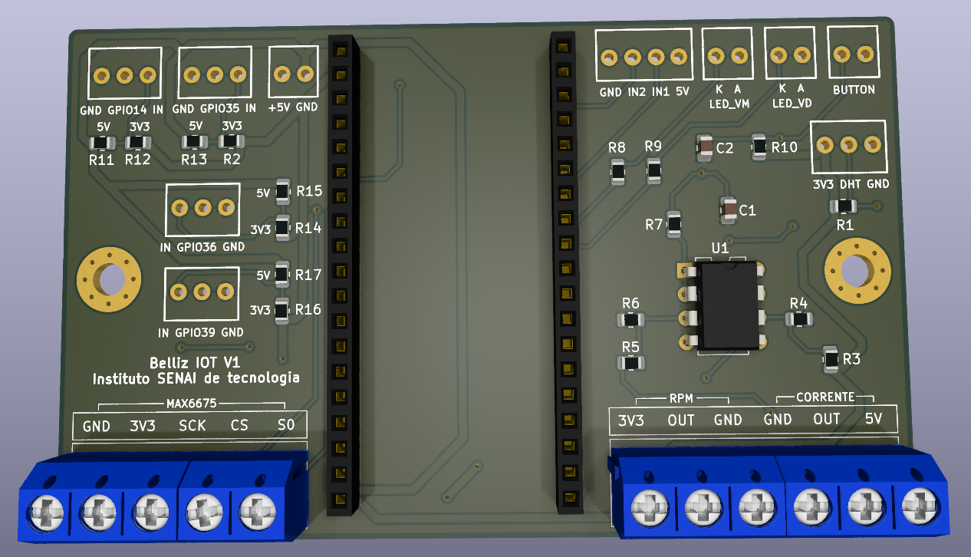
Hardware/Placa V2 Fabricação/Rederização placa frontal.png
