VictorRavani/Belliz_IOT/Hardware/Circuito Elétrico/Circuito elétrico V1.1.pdf

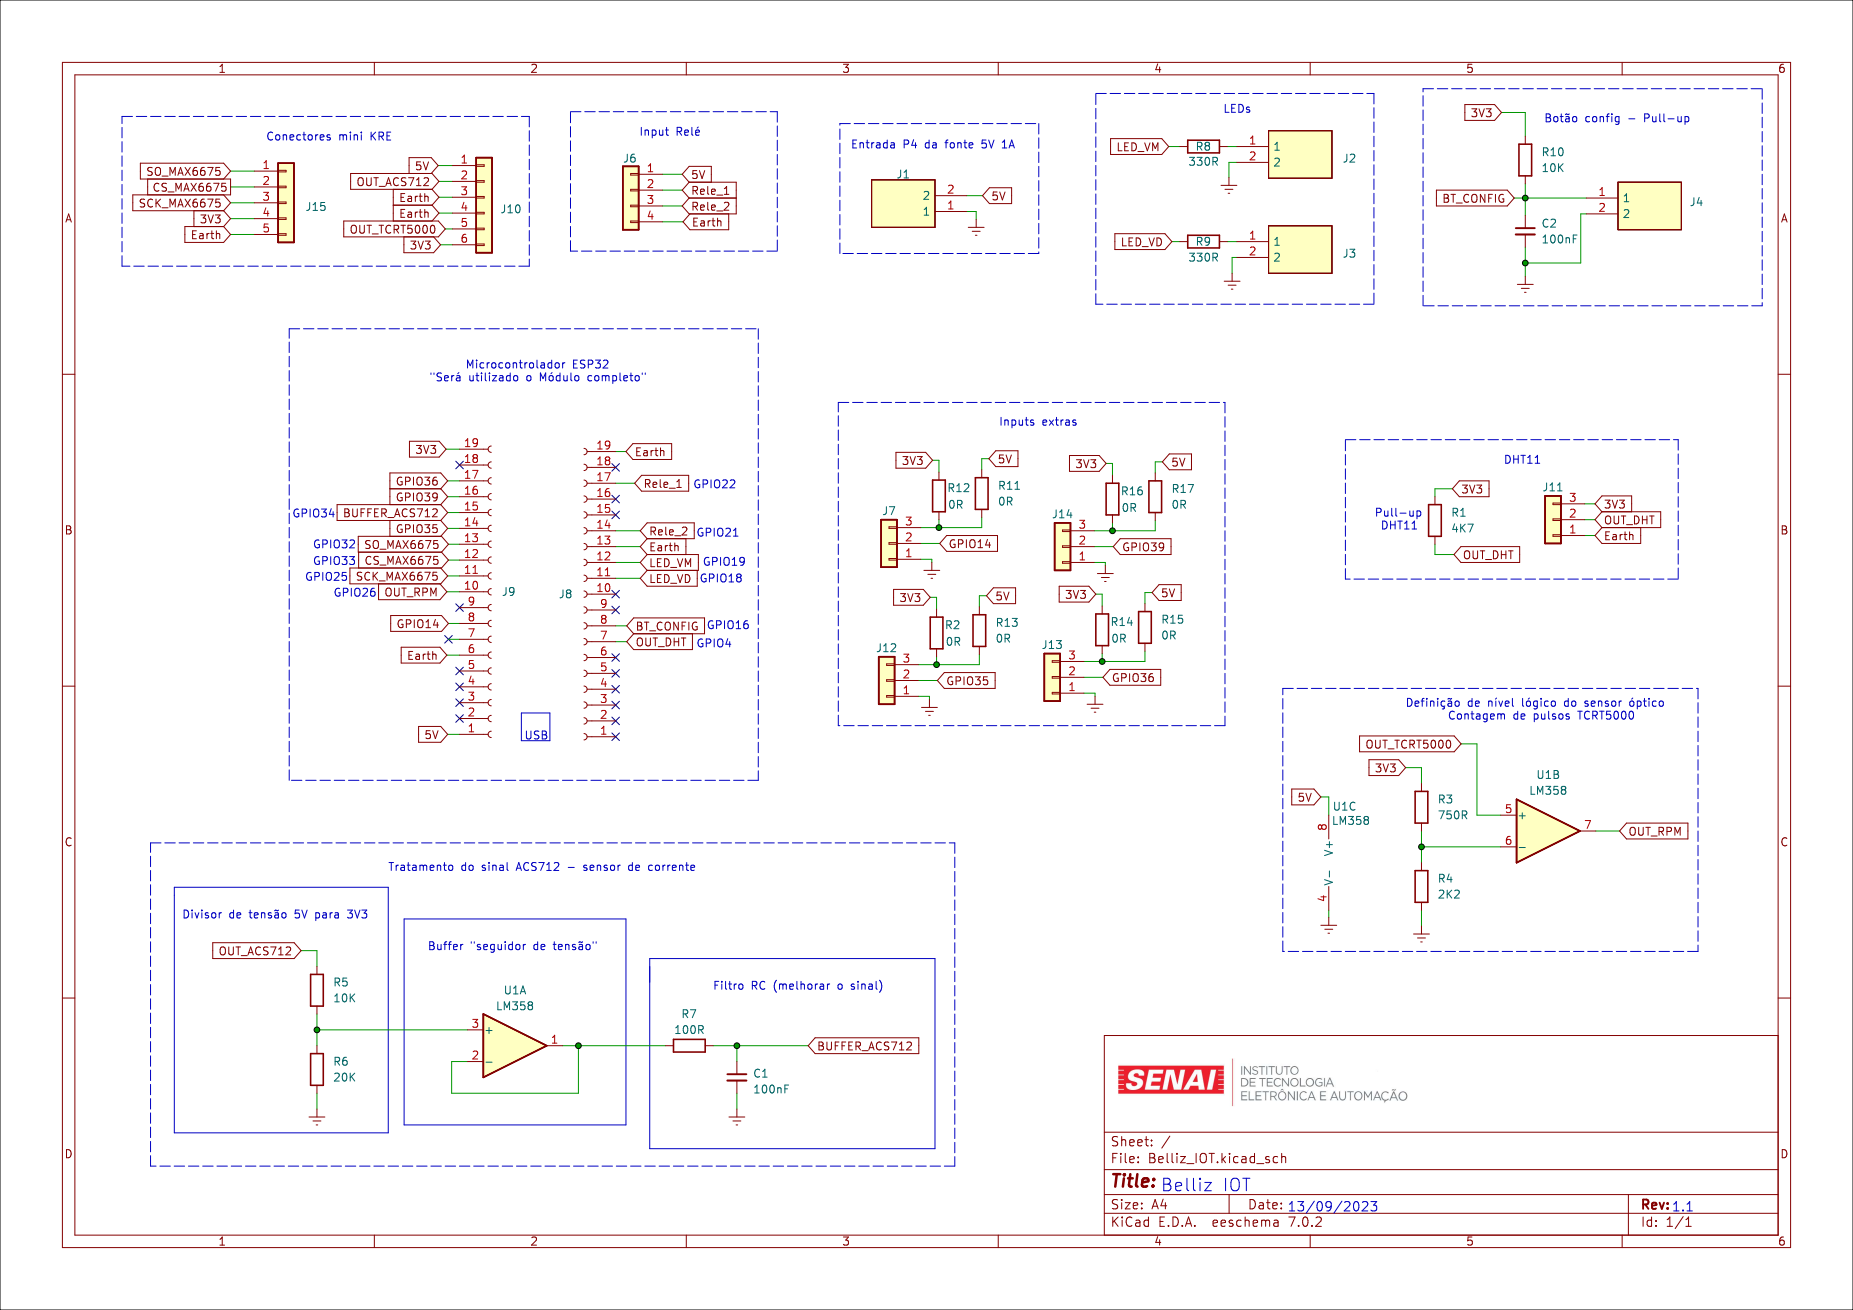
[picture p38: page 1]
