VictorRavani/Belliz_IOT/Hardware/Circuito Elétrico/Circuito Elétrico.pdf

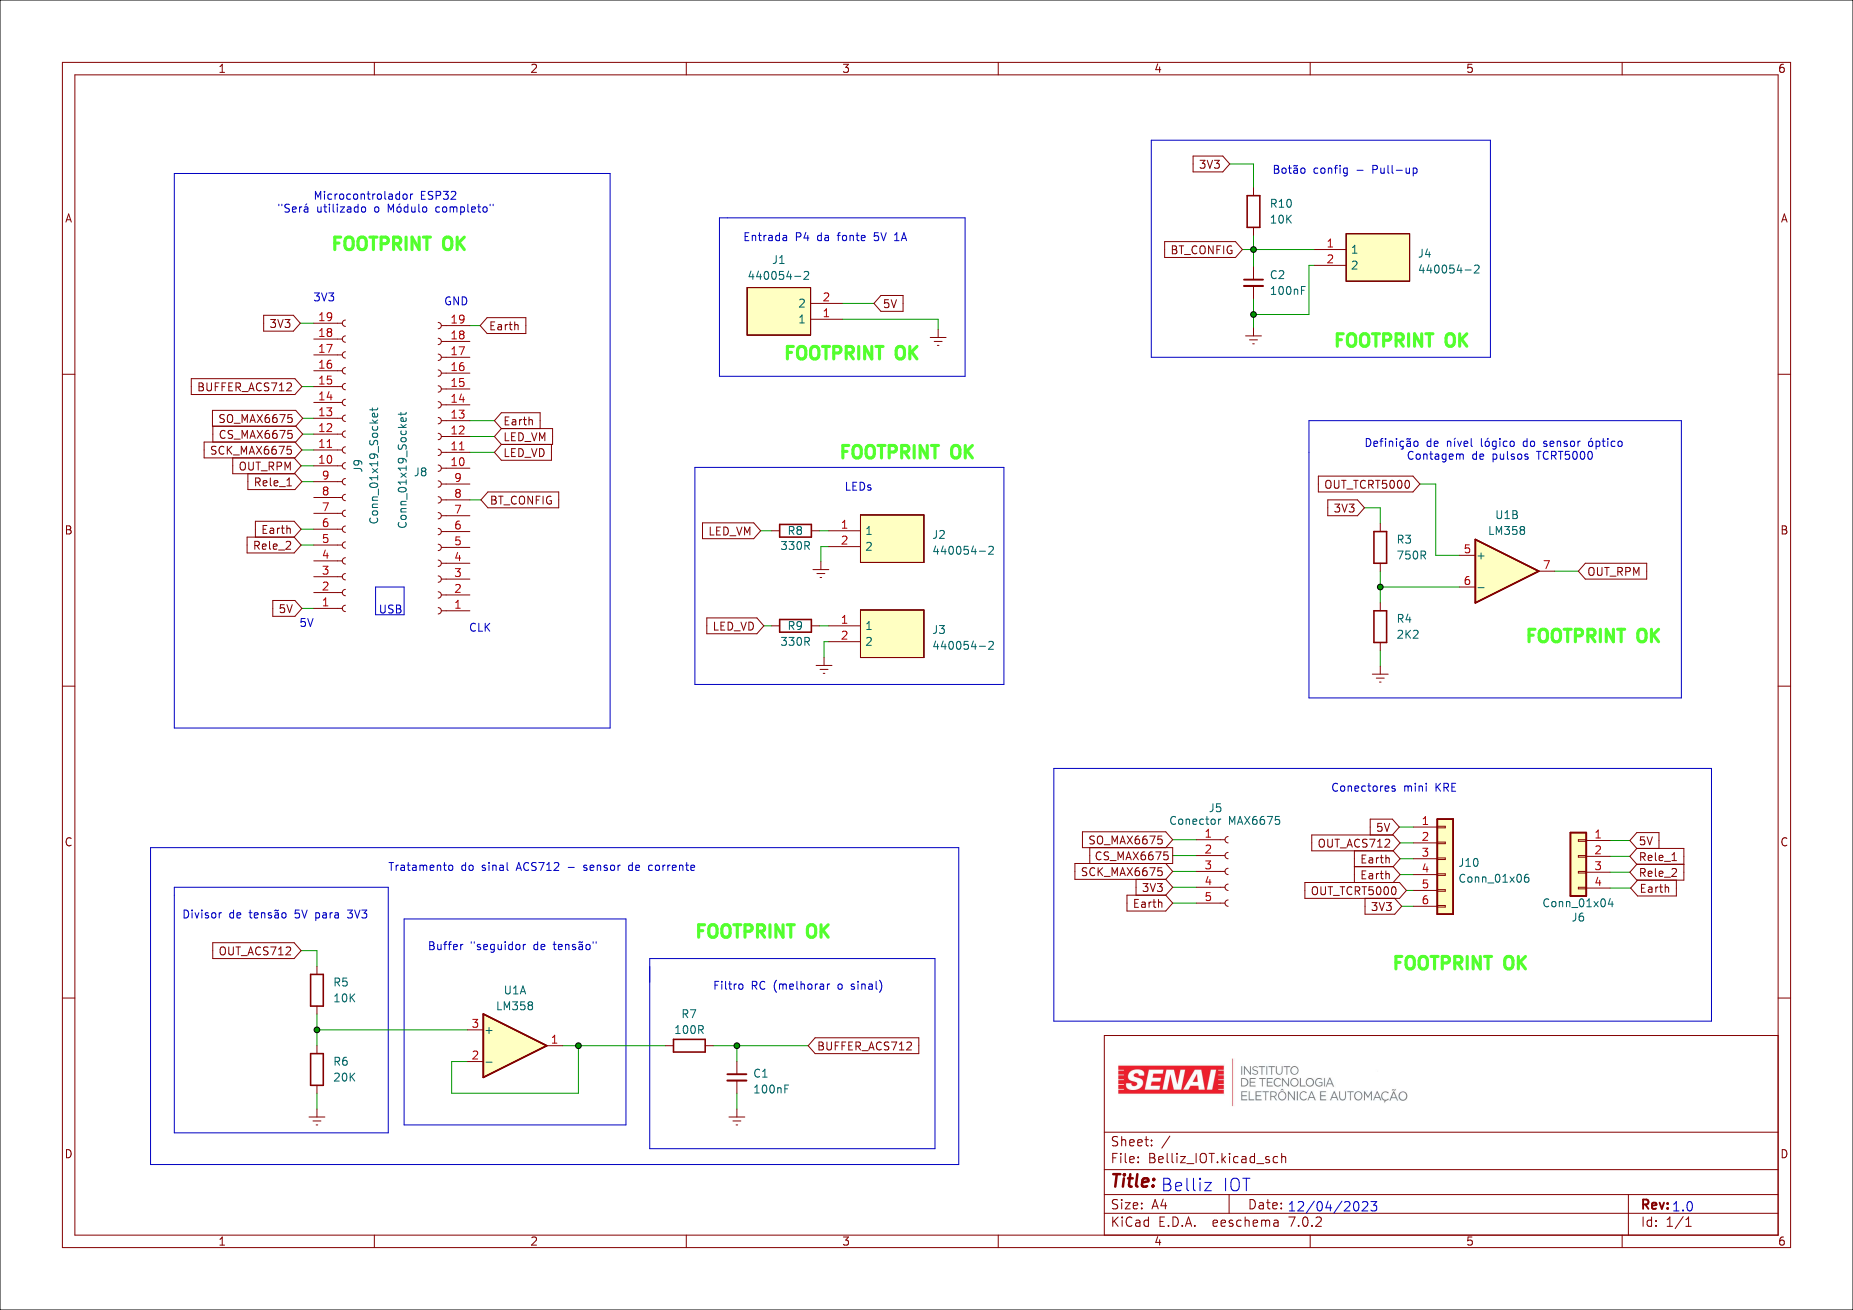
[picture p39: page 1]
