VictorRavani/Belliz_IOT/Hardware/Circuito Elétrico/Circuito elétrico Belliz IOT.pdf

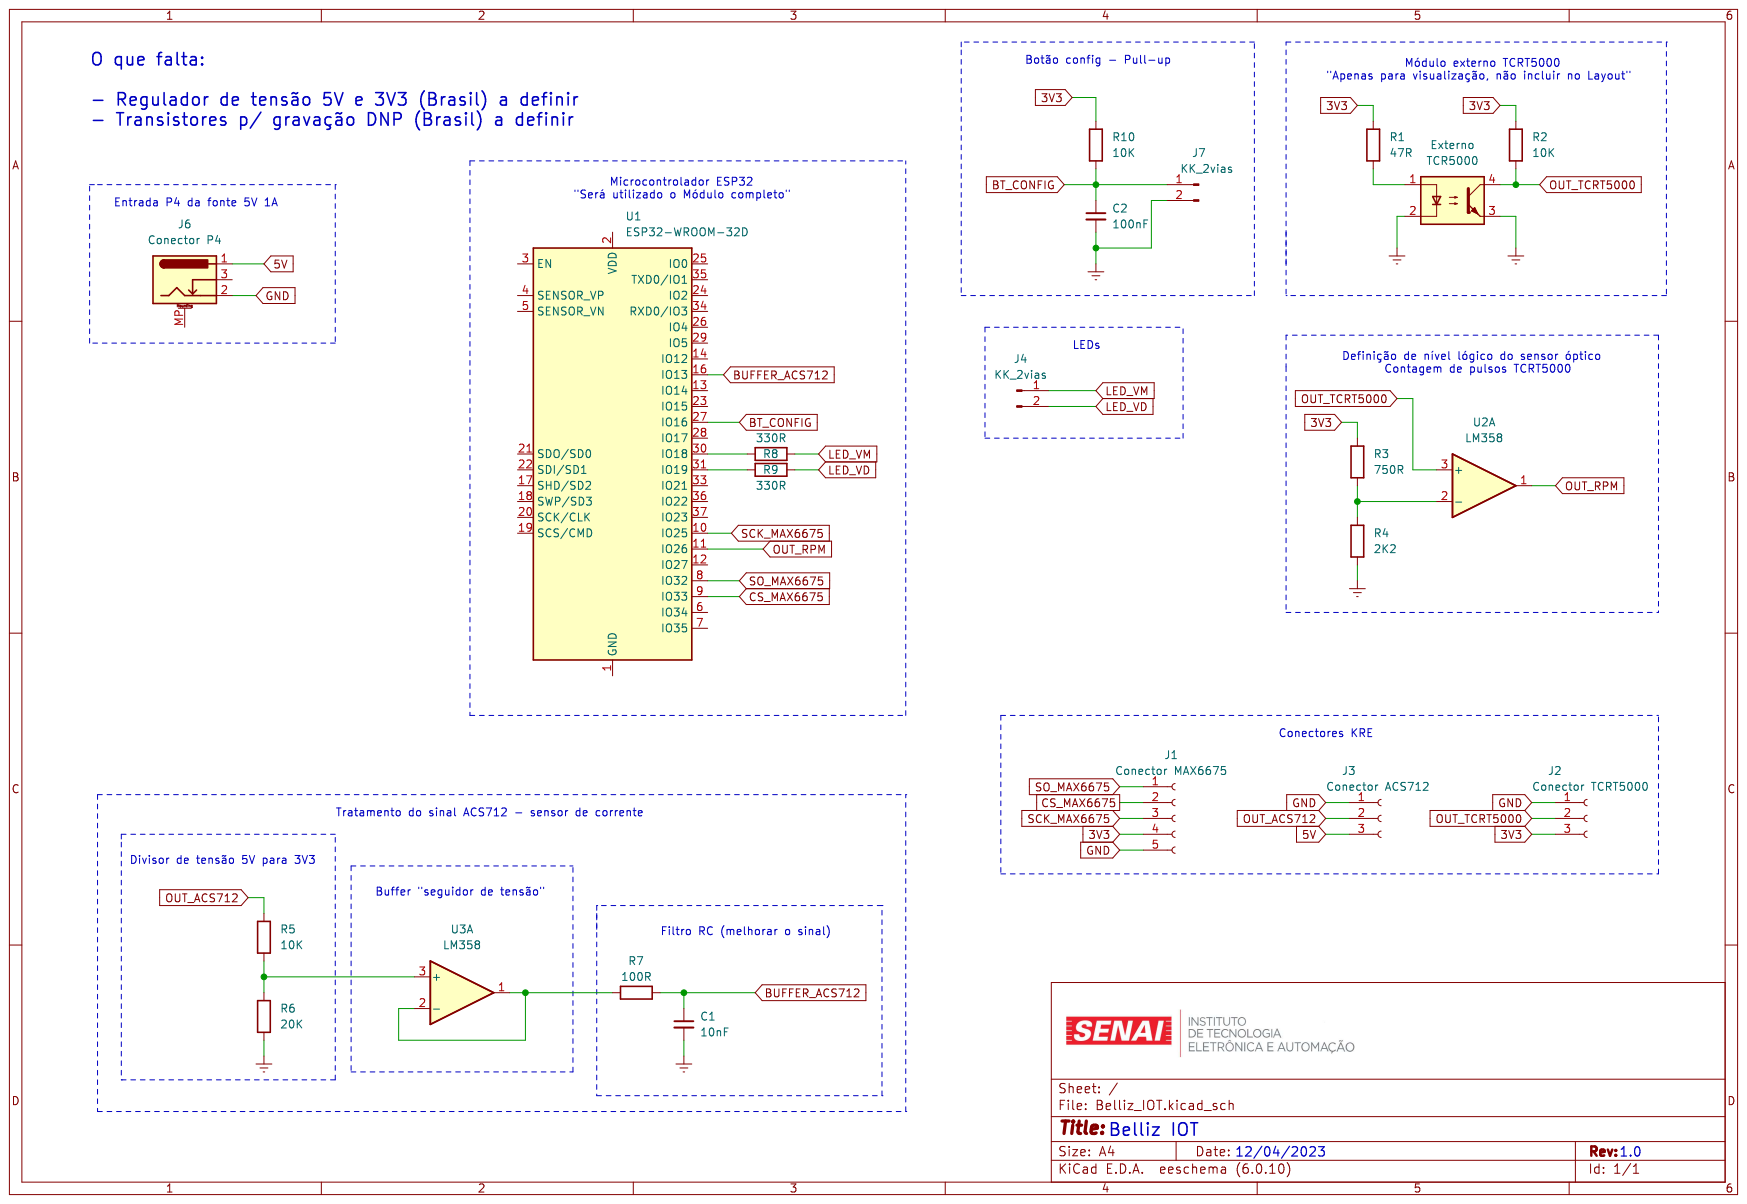
[picture p40: page 1]
