VictorRavani/Belliz_IOT/Hardware/Detector de incendio/PCB_Incendio/PCB_Incendio.kicad_pcb

## KiCad design Hardware/Detector de incendio/PCB_Incendio/PCB_Incendio.kicad_pcb (2024-01-03)

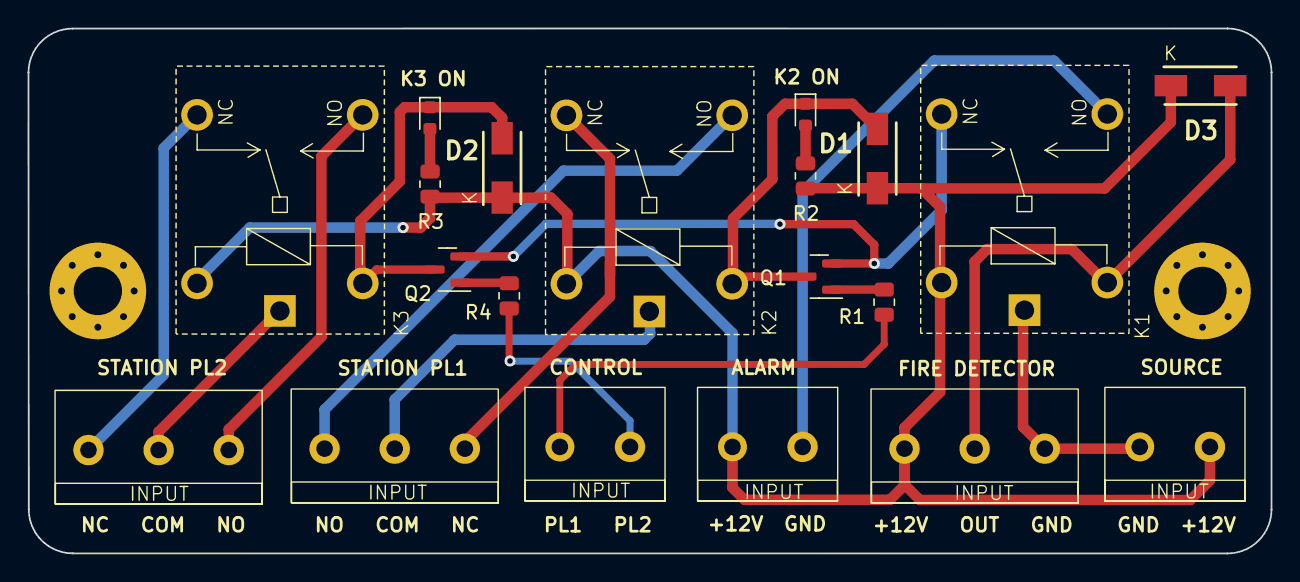
[picture p41: board PCB_Incendio.kicad_pcb from above]

Board: 2 copper layers, 90.0 x 38.0 mm, 21 parts (1 on the bottom side), 19 nets.

Parts:
D1, D2, D3: 1N4007; Diodo_SM_DO-214
J1, J2, J6: KRE_2Vias
J3, J4, J5: KRE_3_vias; KRE_3Vias
K1, K2, K3: AX1RC2; AX1RC
LED1, LED2: LED_VM; LED_0603_1608Metric
Q1, Q2: BC817; SOT-23
R1, R4: 2K2; R_0805_2012Metric
R2, R3: 820R; R_0805_2012Metric
Ref**: Val**; Logo_SENAI_PCB_V3

Connections:
12V: D1.1 (K), D2.1 (K), D3.1 (K), J1.1, J2.2, J5.3, K1.5, K2.5, K3.5, R2.1, R3.1
unnamed: D1.2 (A), K2.1, LED1.1 (K), Q1.3 (C)
unnamed: D2.2 (A), K3.1, LED2.1 (K), Q2.3 (C)
unnamed: D3.2 (A), J5.2, K1.1
unnamed: J1.2, J5.1, K1.2
unnamed: J2.1, K1.3
unnamed: J3.1, K2.4
unnamed: J3.2, K2.2
unnamed: J3.3, K2.3
unnamed: J4.1, K3.3
unnamed: J4.2, K3.2
unnamed: J4.3, K3.4
unnamed: LED1.2 (A), R2.2
unnamed: LED2.2 (A), R3.2
unnamed: Q1.1 (B), R1.2
unnamed: K1.4, Q1.2 (E), Q2.2 (E)
unnamed: Q2.1 (B), R4.2
PL1: J6.2, R1.1
PL2: J6.1, R4.1
