VictorRavani/Belliz_IOT/Hardware/Circuito Elétrico/Belliz_IOT.kicad_pcb

## KiCad design Hardware/Circuito Elétrico/Belliz_IOT.kicad_pcb (2024-04-18)

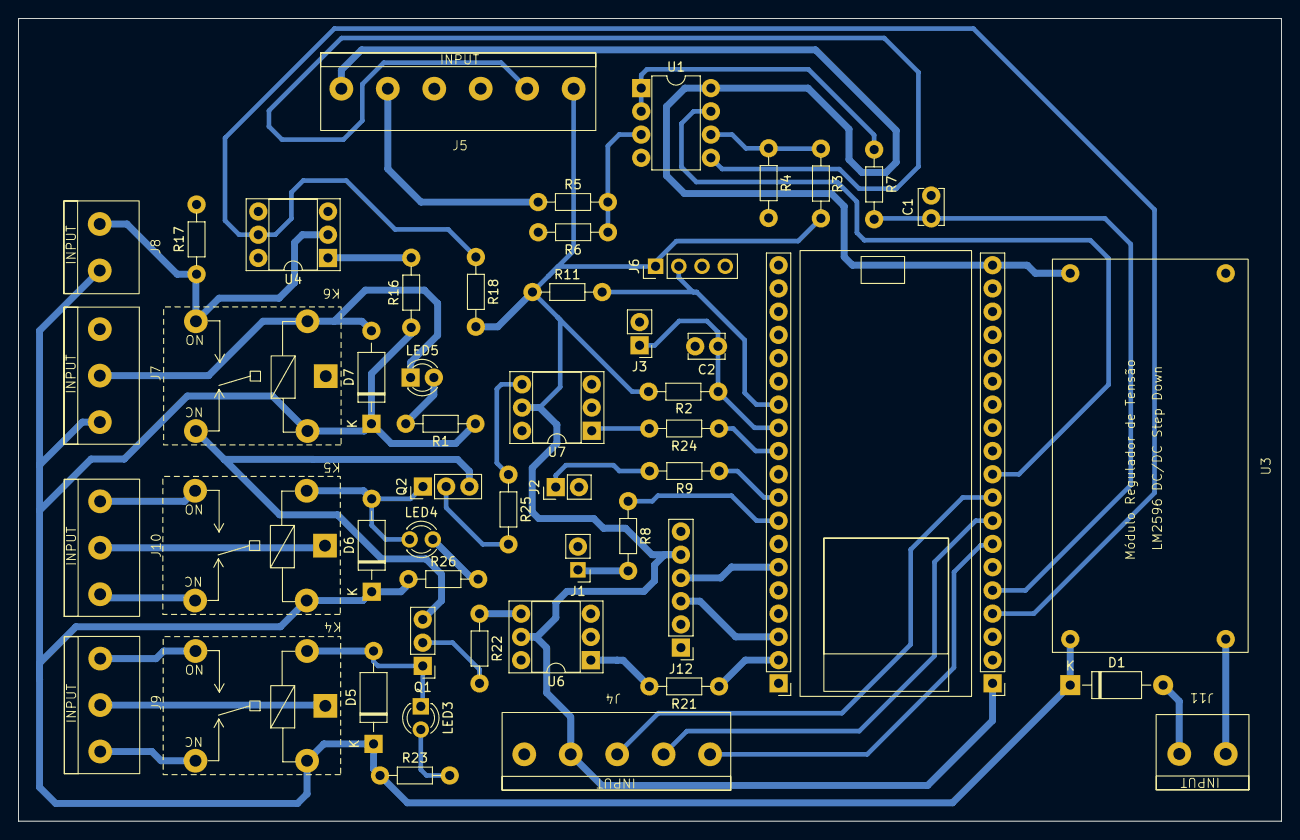
[picture p42: board Belliz_IOT.kicad_pcb from above]

Board: 2 copper layers, 138.1 x 87.8 mm, 51 parts (0 on the bottom side), 48 nets.

Parts:
C1, C2: 100nF; C_Disc_D3.8mm_W2.6mm_P2.50mm
D1, D5, D6, D7: 1N4007; D_DO-41_SOD81_P10.16mm_Horizontal
J1: Led Vermelho; PinHeader_1x02_P2.54mm_Vertical
J2: Led Verde; PinHeader_1x02_P2.54mm_Vertical
J3: Botão config; PinHeader_1x02_P2.54mm_Vertical
J4: Conn_01x05; KRE_5Vias
J5: Conn_01x06; KRE_6Vias
J6: DHT22; PinHeader_1x04_P2.54mm_Vertical
J7, J9, J10: KRE_3_vias; KRE_3Vias
J8, J11: KRE_2Vias
J12: RTC-DS3231; PinHeader_1x06_P2.54mm_Vertical
K4, K5, K6: AX1RC2; AX1RC
LED3, LED4, LED5: LED_VM; LED_D3.0mm
Q1, Q2: BC547; PinHeader_1x03_P2.54mm_Vertical
R1, R23, R26: 820R; R_Axial_DIN0204_L3.6mm_D1.6mm_P7.62mm_Horizontal
R2, R5, R18: 10K; R_Axial_DIN0204_L3.6mm_D1.6mm_P7.62mm_Horizontal
R3: 750R; R_Axial_DIN0204_L3.6mm_D1.6mm_P7.62mm_Horizontal
R4: 2K2; R_Axial_DIN0204_L3.6mm_D1.6mm_P7.62mm_Horizontal
R6: 20K; R_Axial_DIN0204_L3.6mm_D1.6mm_P7.62mm_Horizontal
R7: 100R; R_Axial_DIN0204_L3.6mm_D1.6mm_P7.62mm_Horizontal
R8, R9, R21, R24: 330R; R_Axial_DIN0204_L3.6mm_D1.6mm_P7.62mm_Horizontal
R11: 4K7; R_Axial_DIN0204_L3.6mm_D1.6mm_P7.62mm_Horizontal
R16: 3K3; R_Axial_DIN0204_L3.6mm_D1.6mm_P7.62mm_Horizontal
R17: 220K; R_Axial_DIN0204_L3.6mm_D1.6mm_P7.62mm_Horizontal
R22, R25: 1K; R_Axial_DIN0204_L3.6mm_D1.6mm_P7.62mm_Horizontal
U1: LM358; DIP-8_W7.62mm
U3: Módulo_DC-DC_2576
U4, U6, U7: CNY17-1; DIP-6_W7.62mm_Socket
U5: ESP32_DevKit

Connections:
+3.3V: J4.4, J5.6, J6.1, J12.5, R2.1, R3.1, R11.1, R18.2, U5.1 (3V3), U6.5, U7.5
+5V: J5.1, U1.8 (V+), U3.3 (OUT+), U5.19 (5V)
+12V: D1.1 (K), D5.1 (K), D6.1 (K), D7.1 (K), J7.1, J8.1, K4.5, K5.5, K6.5, R1.1, R16.1, R23.1, R26.1, U3.1 (IN+)
/Microcontroller/ACS712_BUF: C1.1, R7.2, U5.5 (GPIO34/ADC6)
/Microcontroller/ACS712_OUT: J5.2, R5.1
/Microcontroller/BT_CONFIG: C2.1, J3.1, R2.2, U5.27 (GPIO16/RX2)
/Microcontroller/DHT22: J6.2, R11.2, U5.26 (GPIO4/ADC10)
/Microcontroller/FIRE_GPIO: R18.1, U4.5, U5.4 (GPIO39/ADC3)
/Microcontroller/LED_VD: R9.1, U5.30 (GPIO18/SCK)
/Microcontroller/LED_VM: R8.1, U5.31 (GPIO19/MISO)
/Microcontroller/MAX6675_CS: J4.2, U5.8 (GPIO33/ADC5)
/Microcontroller/MAX6675_SCK: J4.3, U5.9 (GPIO25/ADC18)
/Microcontroller/MAX6675_SO: J4.1, U5.7 (GPIO32/ADC4)
/Microcontroller/OUT_RPM: U1.7, U5.10 (GPIO26/ADC19)
/Microcontroller/RELE_1: R21.1, U5.37 (GPIO23/MOSI)
/Microcontroller/RELE_2: R24.1, U5.28 (GPIO17/TX2)
/Microcontroller/SCL: J12.3, U5.36 (GPIO22/SCL)
/Microcontroller/SDA: J12.4, U5.33 (GPIO21/SDA)
/Microcontroller/TCRT5000: J5.5, U1.5 (+)
/Reles/COM_1: J9.2, K4.2
/Reles/COM_2: J10.2, K5.2
/Reles/GND2: K6.4, Q1.3 (E), Q2.3 (E)
/Reles/OUT_DETECTOR: D7.2 (A), J7.2, K6.1, LED5.1 (K)
/Reles/RELE_1_NA: J9.3, K4.3
/Reles/RELE_1_NF: J9.1, K4.4
/Reles/RELE_2_NA: J10.3, K5.3
/Reles/RELE_2_NF: J10.1, K5.4
/Reles/RELE_3_NA: J8.2, K6.3, R17.1, U4.2
Earth: C1.2, C2.2, J1.2, J2.2, J3.2, J4.5, J5.3, J5.4, J6.4, J7.3, J12.6, K6.2, R4.2, R6.2, R17.2, U1.4 (V-), U3.4 (OUT-), U4.4, U5.14 (GND), U5.32 (GND), U5.38 (GND), U6.2, U7.2
unnamed: D1.2 (A), J11.2
unnamed: D5.2 (A), K4.1, LED3.1 (K), Q1.1 (C)
unnamed: D6.2 (A), K5.1, LED4.1 (K), Q2.1 (C)
unnamed: J1.1, R8.2
unnamed: J2.1, R9.2
unnamed: LED3.2 (A), R23.2
unnamed: LED4.2 (A), R26.2
unnamed: LED5.2 (A), R1.2
unnamed: Q1.2 (B), R22.2
unnamed: Q2.2 (B), R25.2
unnamed: R16.2, U4.1
unnamed: R21.2, U6.1
unnamed: R22.1, U6.4
unnamed: R24.2, U7.1
unnamed: R25.1, U7.4
unnamed: R5.2, R6.1, U1.3 (+)
unnamed: R7.1, U1.1, U1.2 (-)
unnamed: R3.2, R4.1, U1.6 (-)
unnamed: J11.1, U3.2 (IN_-)
