VictorRavani/Belliz_IOT/(commit log)

2023-05-12 Priemiro commit
    [Firmware configuracao ADC1.txt]
2023-05-18 Atualização do circuito eletrico
    [Belliz_IOT.kicad_sch, Lista de materiais.xlsx, Tacometro.xlsx]
2023-05-18 Atualização do circuito eletrico 2
    [Belliz_IOT.kicad_sch]
2024-01-03 Inclusao da pasta do fw
    [Belliz_IOT-B_Cu.gbr, Belliz_IOT-B_Mask.gbr, Belliz_IOT-B_Paste.gbr, Belliz_IOT-B_Silkscreen.gbr, Belliz_IOT-Edge_Cuts.gbr, Belliz_IOT-F_Cu.gbr, Belliz_IOT-F_Mask.gbr, Belliz_IOT-F_Paste.gbr]
2024-01-03 Atualizacao de fw, organização e padronização
2024-01-05 código funcional
    [Belliz_IOT.kicad_sch]
2024-01-12 Sensor de incêncio e leds
    [PCB_Incendio.kicad_sch]
2024-01-16 finalização parcial - Pronto para testes
    [Curva RPM.xlsx, Pasta1.xlsx]
2024-01-18 Atualização detector de incêndio
    [PCB_Incendio.kicad_sch]
2024-04-18 atualização de arquivos
    [ADDRESS DEVICES.xlsx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]
2024-05-17 Atualização da última versão de firmware
